IllyaMoore/Modular-10-10-inch-Rack---A1-mini-version/cad/minirack-assembly.FCStd

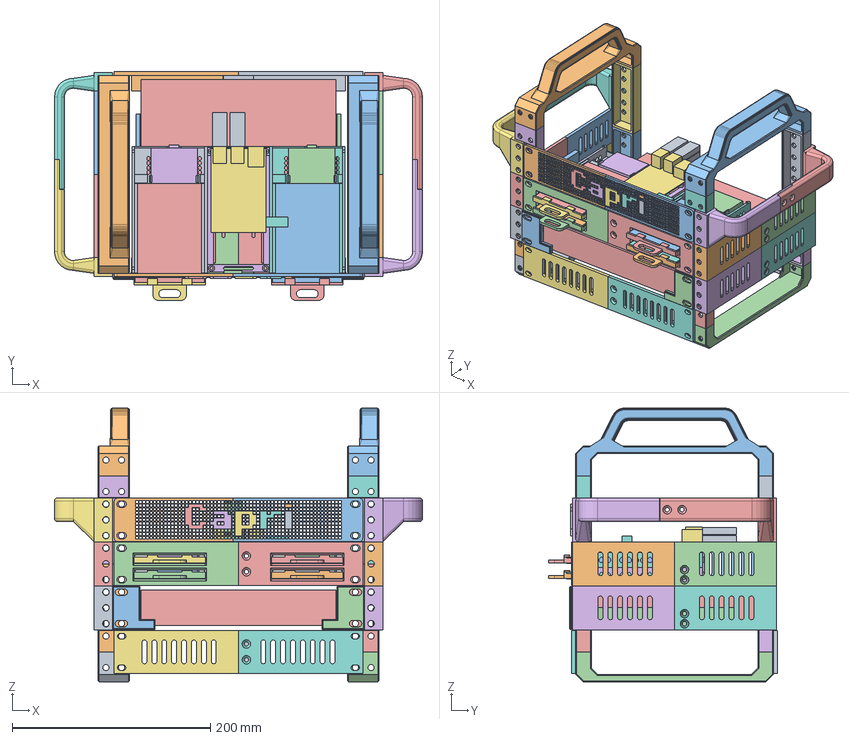
[picture p6: CAD file, 2026-11-12]
cad/minirack-assembly.FCStd
371.6 x 231.5 x 276.4 mm
foot_L
upright_front_L
upright_back_L
foot_R
upright_front_R
upright_back_R
join_front_L
join_front_R
join_back_L
join_back_R
mini_bracket_L
mini_bracket_R
macmini_ghost
upright_front_L_top
upright_back_L_top
upright_front_R_top
upright_back_R_top
handle_L
handle_R
nas_base_L
nas_base_R
nas_sock_R_low
nas_sock_L_low
nas_sock_R_up
nas_sock_L_up
hdd_1
sata_adapter_1
hdd_handle_1
hdd_2
sata_adapter_2
hdd_handle_2
hdd_3
sata_adapter_3
hdd_handle_3
hdd_4
sata_adapter_4
hdd_handle_4
sidesupport_U2_R_front
sidesupport_U2_L_front
sidesupport_U2_R_back
sidesupport_U2_L_back
sidesupport_U3_R_front
sidesupport_U3_L_front
sidesupport_U3_R_back
sidesupport_U3_L_back
nas_pi_holder
pi3b_board
pi3b_power_plug
pi3b_usb_plugs
cover_plate_L
cover_plate_R
cover_splice_bar
cover_letter_1
cover_letter_2
cover_letter_3
cover_letter_4
cover_letter_5
cover_letter_6
macmini_cover_L
macmini_cover_R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
