IllyaMoore/Modular-10-10-inch-Rack---A1-mini-version/print/cover/cover-plate.3mf

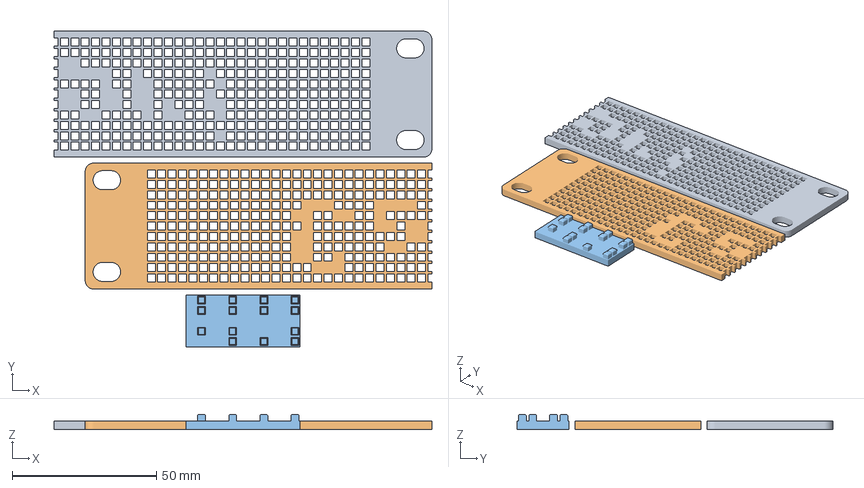
[picture p7: CAD file, 2026-11-12]
print/cover/cover-plate.3mf
130.9 x 109.3 x 5.20 mm
cover-plate-right.stl
cover-plate-left.stl
cover-splice-bar.stl
