IllyaMoore/Modular-10-10-inch-Rack---A1-mini-version/print/macmini/macmini-cover-left-right.3mf

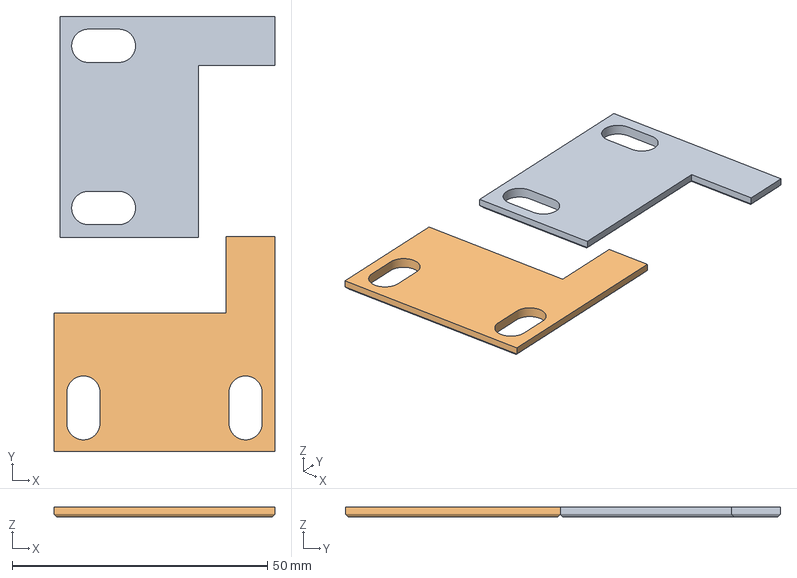
[picture p8: CAD file, 2026-11-12]
print/macmini/macmini-cover-left-right.3mf
43.3 x 85.2 x 2.00 mm
macmini-cover-left.stl
macmini-cover-right.stl
