IllyaMoore/Modular-10-10-inch-Rack---A1-mini-version/print/nas/nas-hdd-handle-x4.3mf

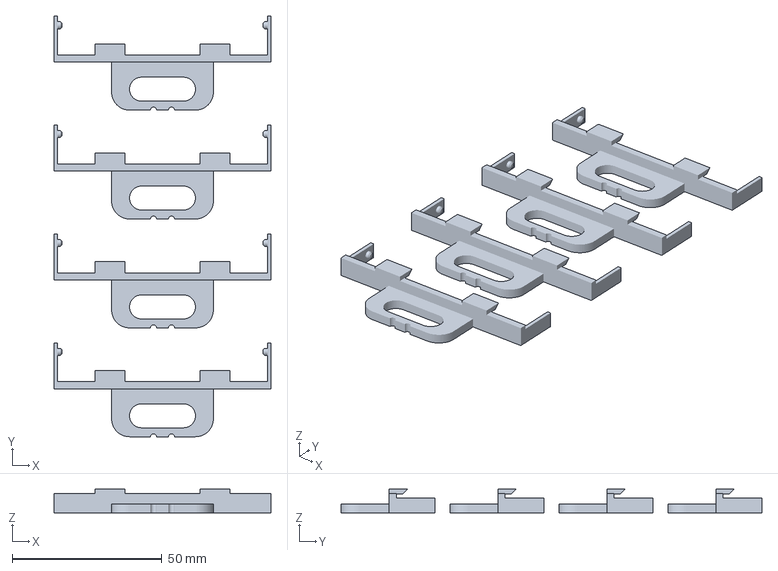
[picture p9: CAD file, 2026-11-12]
print/nas/nas-hdd-handle-x4.3mf
72.4 x 140.4 x 7.95 mm
