IllyaMoore/Modular-10-10-inch-Rack---A1-mini-version/print/shell/shell-foot-x2-gusset-x4.3mf

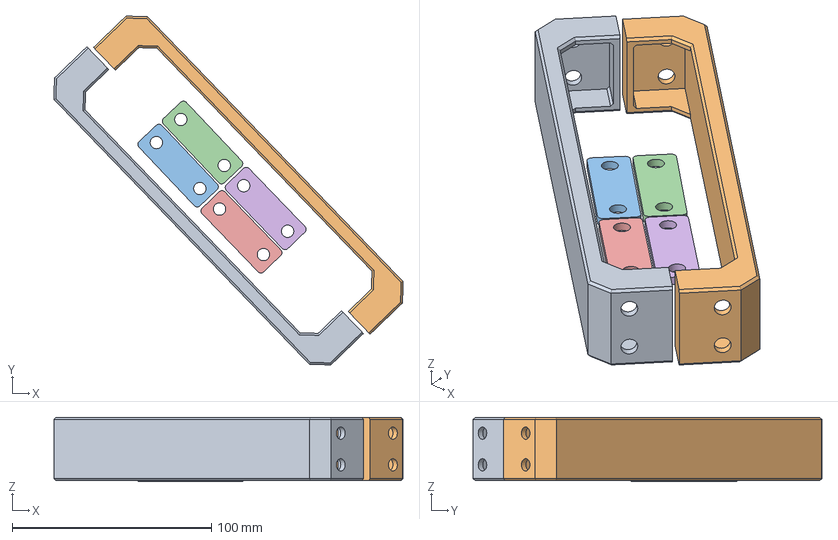
[picture p10: CAD file, 2026-11-12]
print/shell/shell-foot-x2-gusset-x4.3mf
175.2 x 175.0 x 32.3 mm
shell-foot-bwees.stl x 2
shell-gusset-1x3-bwees.stl x 4
