IllyaMoore/Modular-10-10-inch-Rack---A1-mini-version/stl/cover/cover-splice-bar.stl

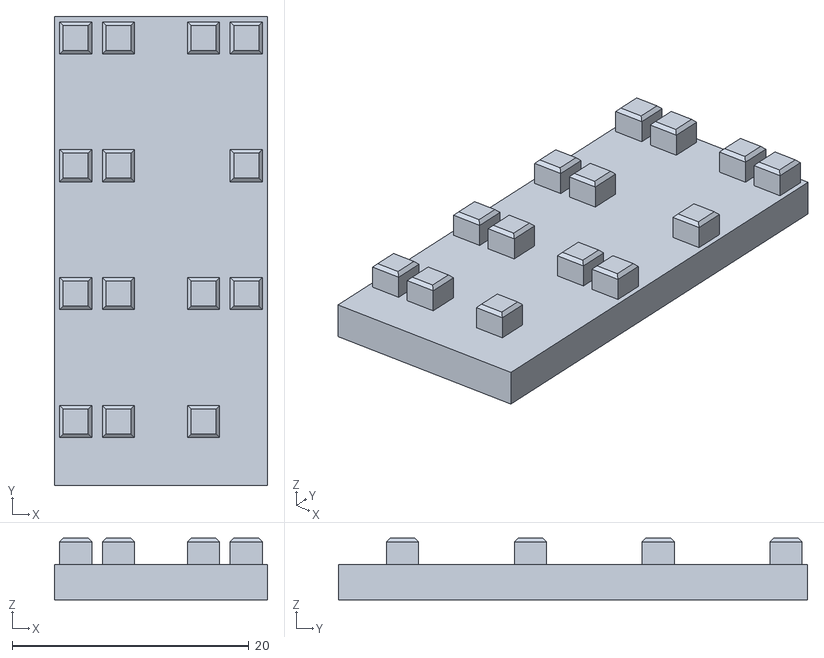
[picture p11: CAD file, 2026-11-12]
stl/cover/cover-splice-bar.stl
18.0 x 39.6 x 5.20
