IllyaMoore/Modular-10-10-inch-Rack---A1-mini-version/stl/macmini/macmini-cover-left.stl

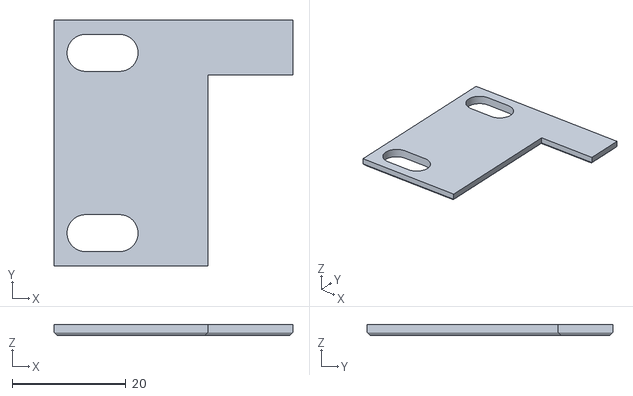
[picture p12: CAD file, 2026-11-12]
stl/macmini/macmini-cover-left.stl
42.1 x 43.3 x 2.00
