IllyaMoore/Modular-10-10-inch-Rack---A1-mini-version/stl/nas/nas-socket-bracket.stl

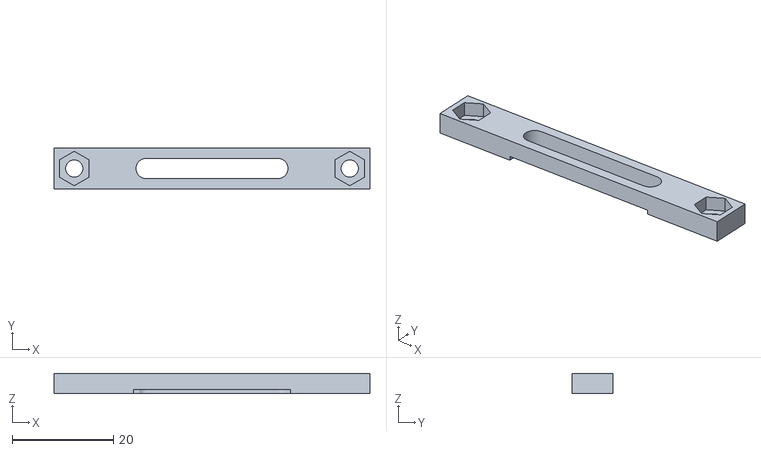
[picture p13: CAD file, 2026-11-12]
stl/nas/nas-socket-bracket.stl
62.4 x 8.00 x 4.00
