IllyaMoore/Modular-10-10-inch-Rack---A1-mini-version/stl/shell/shell-side-handle-front.stl

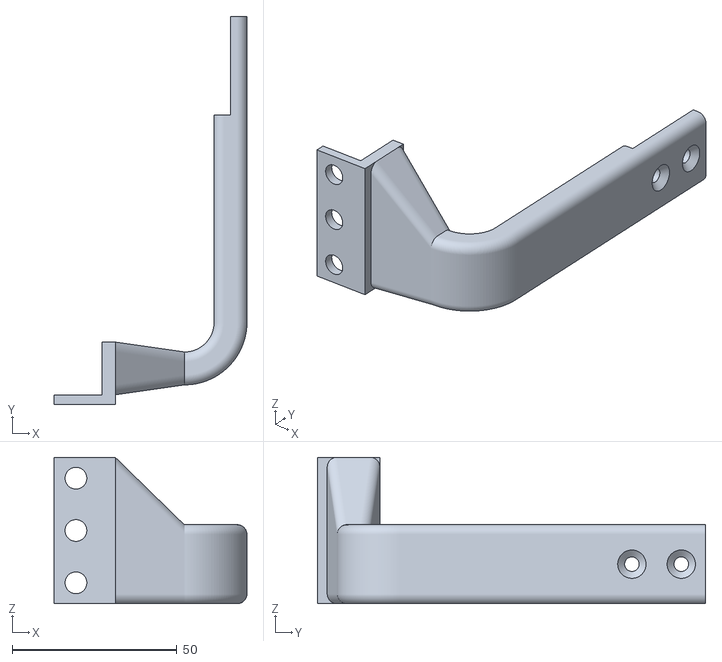
[picture p14: CAD file, 2026-11-12]
stl/shell/shell-side-handle-front.stl
58.6 x 117.9 x 44.5
