IllyaMoore/Modular-10-10-inch-Rack---A1-mini-version/cad/nas-layer.FCStd

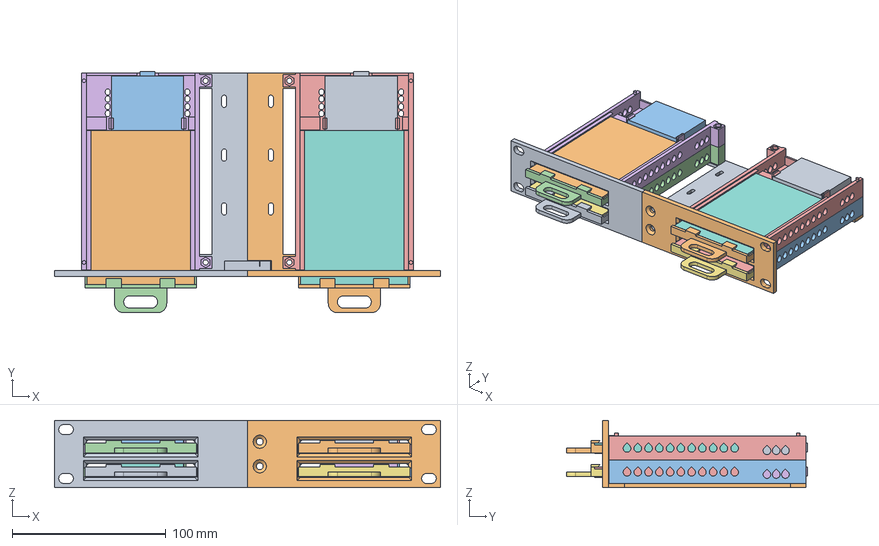
[picture p15: CAD file, 2026-11-12]
cad/nas-layer.FCStd
251.0 x 157.0 x 43.7 mm
base_L
base_R
sock_R_low
sock_L_low
sock_R_up
sock_L_up
drive_1
adapter_1
handle_1
drive_2
adapter_2
handle_2
drive_3
adapter_3
handle_3
drive_4
adapter_4
handle_4
