IllyaMoore/Modular-10-10-inch-Rack---A1-mini-version/print/cover/cover-letters.3mf

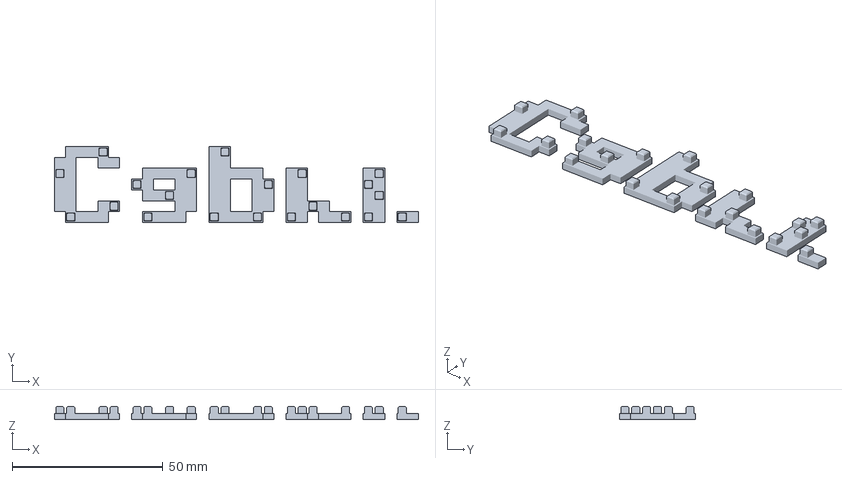
[picture p16: CAD file, 2026-11-12]
print/cover/cover-letters.3mf
120.8 x 25.2 x 4.20 mm
