IllyaMoore/Modular-10-10-inch-Rack---A1-mini-version/print/macmini/macmini-holder-left-right.3mf

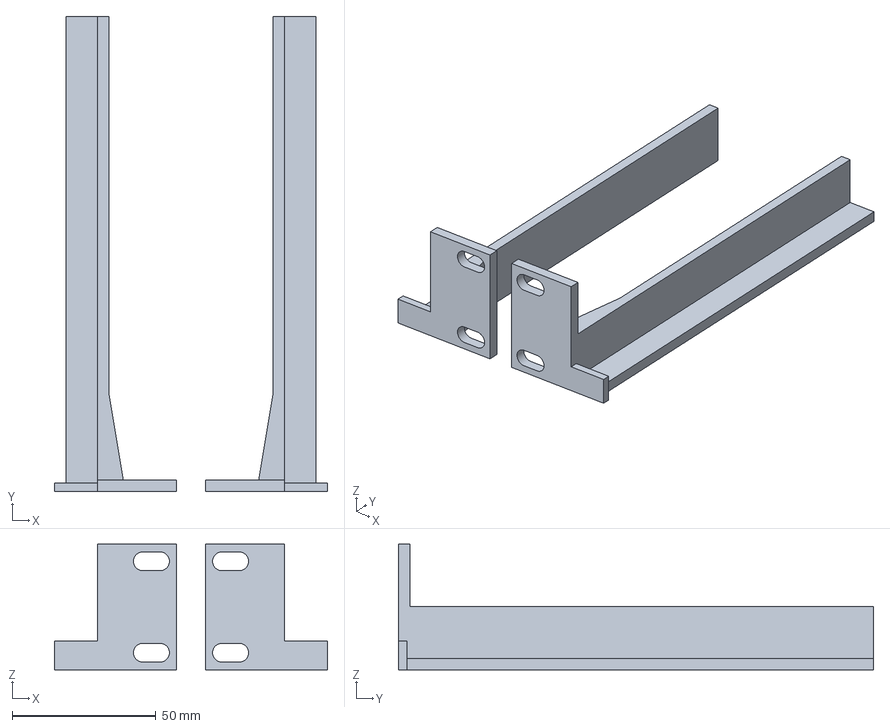
[picture p17: CAD file, 2026-11-12]
print/macmini/macmini-holder-left-right.3mf
95.0 x 165.0 x 43.7 mm
