IllyaMoore/Modular-10-10-inch-Rack---A1-mini-version/print/shell/shell-top-handle.3mf

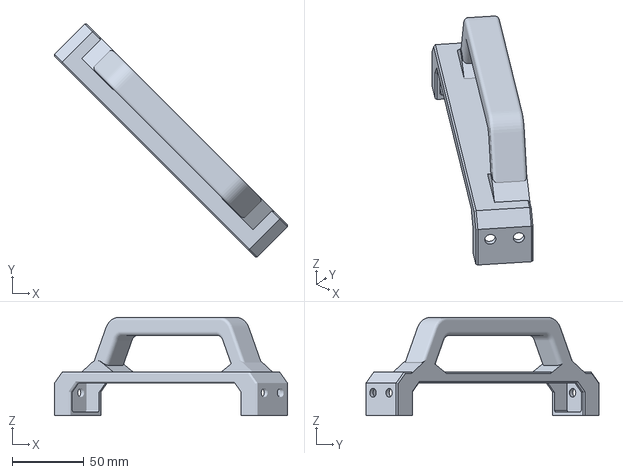
[picture p18: CAD file, 2026-11-12]
print/shell/shell-top-handle.3mf
162.5 x 162.5 x 68.4 mm
