IllyaMoore/Modular-10-10-inch-Rack---A1-mini-version/stl/cover/cover-plate-right.stl

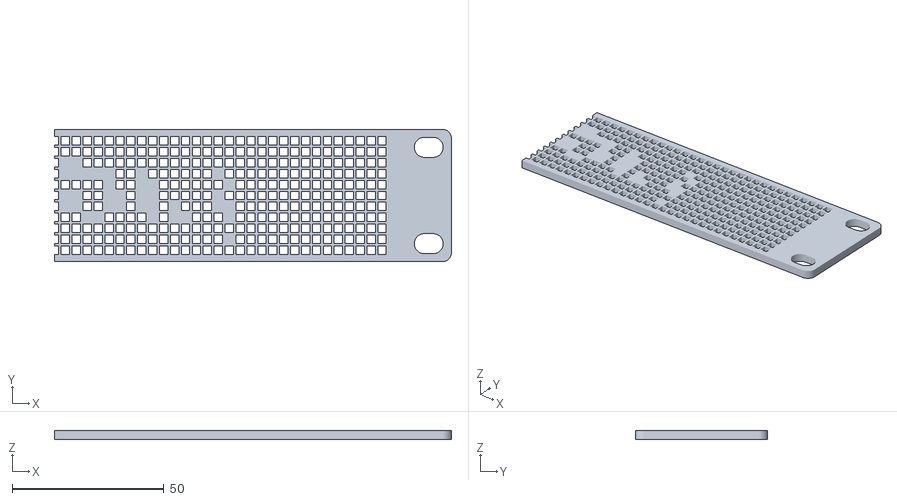
[picture p19: CAD file, 2026-11-12]
stl/cover/cover-plate-right.stl
130.9 x 43.7 x 3.00
