IllyaMoore/Modular-10-10-inch-Rack---A1-mini-version/STL/nas/nas-socket-left.stl

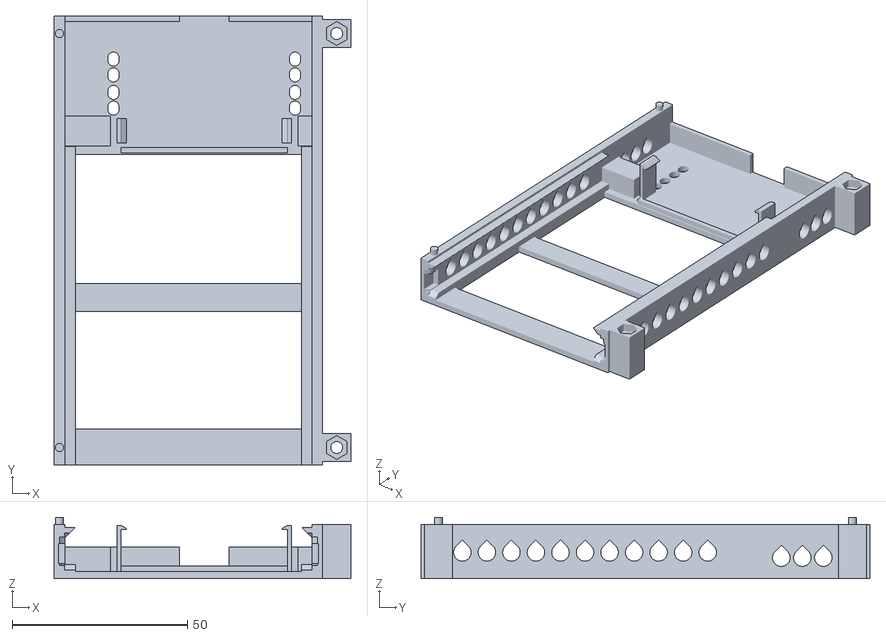
[picture p20: CAD file, 2026-11-09]
STL/nas/nas-socket-left.stl
84.6 x 128.1 x 17.5
