IllyaMoore/Modular-10-10-inch-Rack---A1-mini-version/print/nas/nas-pi-holder-pins.3mf

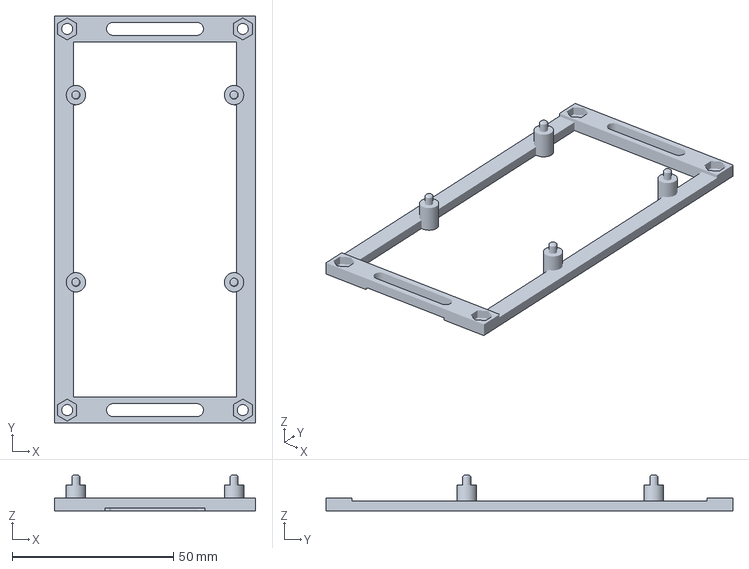
[picture p21: CAD file, 2026-11-12]
print/nas/nas-pi-holder-pins.3mf
62.4 x 126.1 x 11.0 mm
