IllyaMoore/Modular-10-10-inch-Rack---A1-mini-version/print/shell/shell-upright-3u-x4.3mf

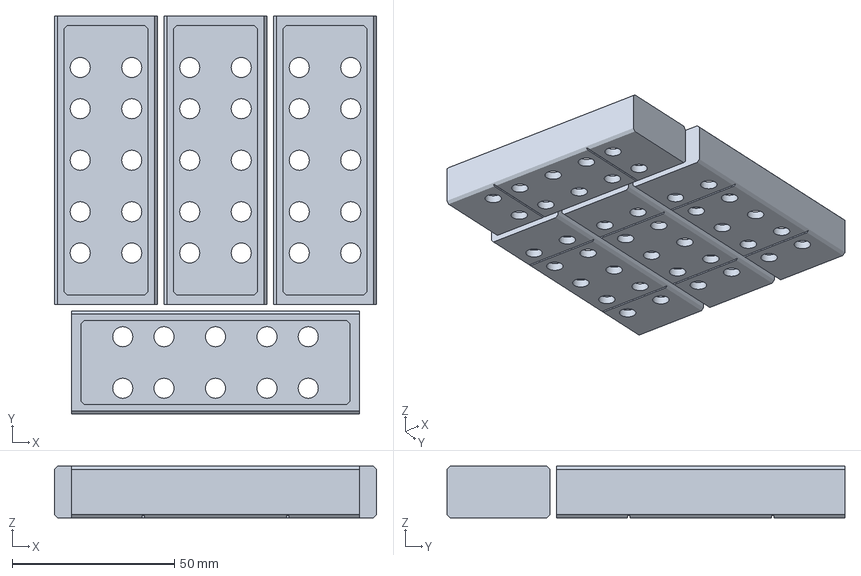
[picture p22: CAD file, 2026-11-12]
print/shell/shell-upright-3u-x4.3mf
99.2 x 122.7 x 15.9 mm
