IllyaMoore/Modular-10-10-inch-Rack---A1-mini-version/stl/cover/cover-plate-left.stl

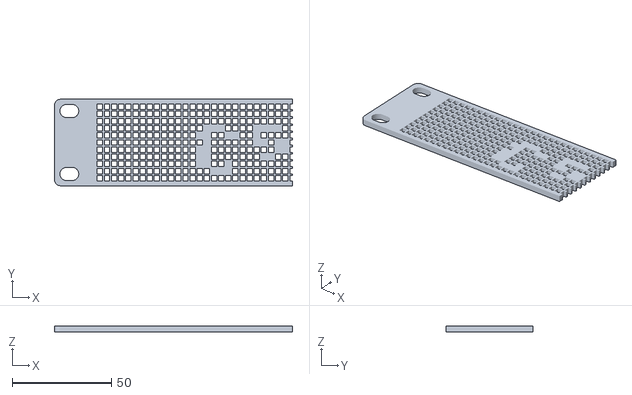
[picture p23: CAD file, 2026-11-12]
stl/cover/cover-plate-left.stl
120.1 x 43.7 x 3.00
