IllyaMoore/Modular-10-10-inch-Rack---A1-mini-version/stl/macmini/macmini-holder-right.stl

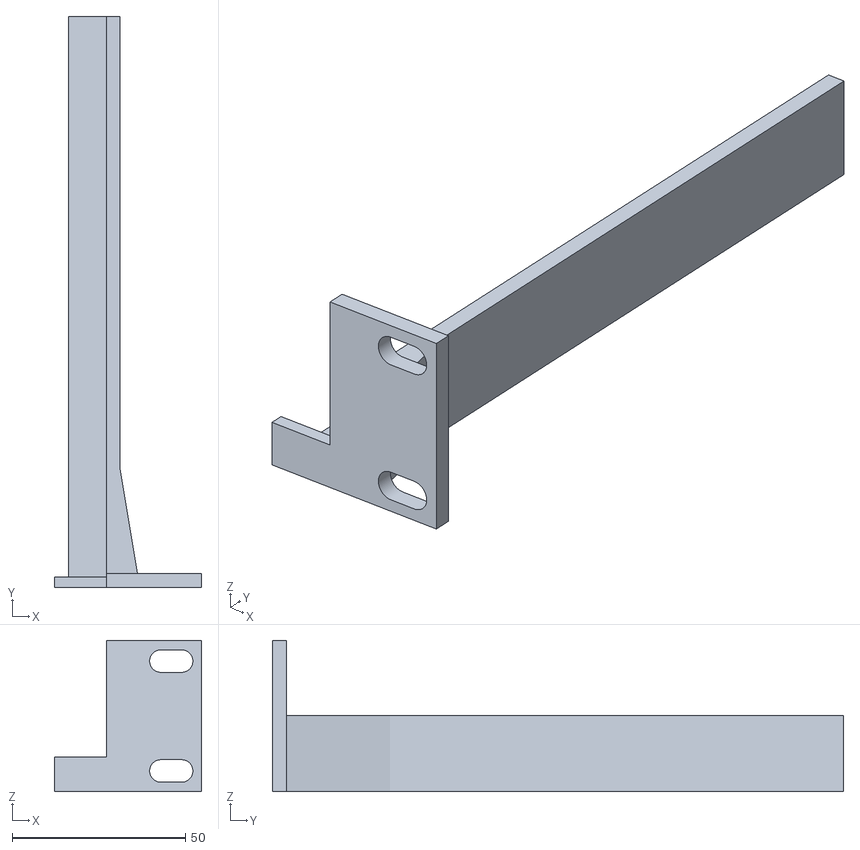
[picture p24: CAD file, 2026-11-04]
stl/macmini/macmini-holder-right.stl
42.5 x 165.0 x 43.7
