IllyaMoore/Modular-10-10-inch-Rack---A1-mini-version/stl/shell/shell-side-support-back.stl

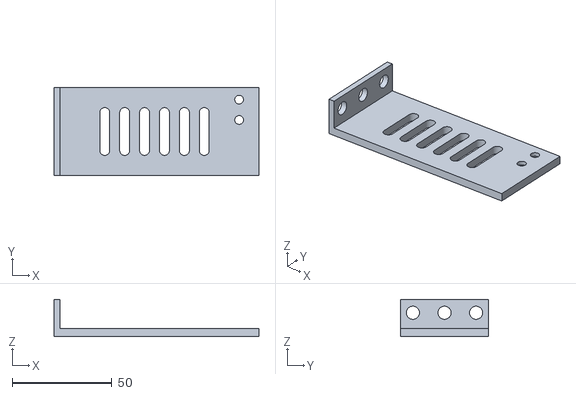
[picture p25: CAD file, 2026-11-09]
stl/shell/shell-side-support-back.stl
103.0 x 44.5 x 18.6
