IllyaMoore/Modular-10-10-inch-Rack---A1-mini-version/print/nas/nas-socket-bracket-x2.3mf

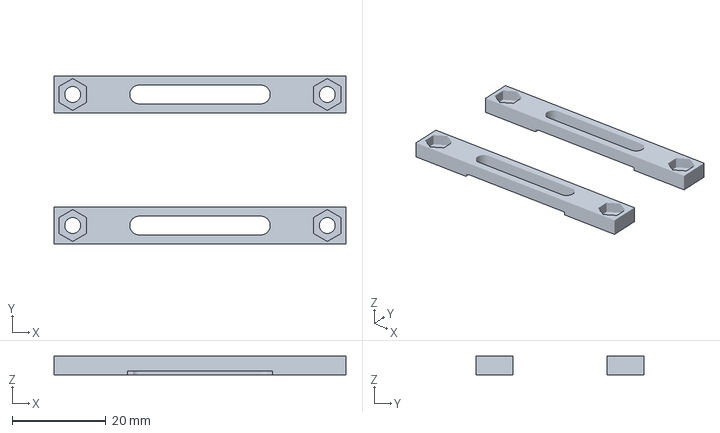
[picture p26: CAD file, 2026-11-12]
print/nas/nas-socket-bracket-x2.3mf
62.4 x 36.0 x 4.00 mm
