IllyaMoore/Modular-10-10-inch-Rack---A1-mini-version/print/shell/shell-side-handle-front-back.3mf

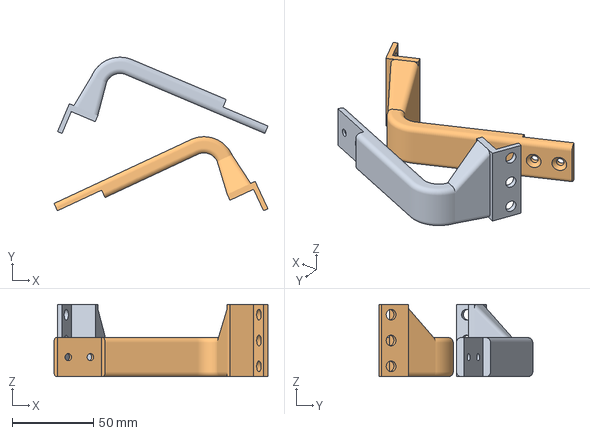
[picture p27: CAD file, 2026-11-12]
print/shell/shell-side-handle-front-back.3mf
131.6 x 94.5 x 44.5 mm
shell-side-handle-back.stl
shell-side-handle-front.stl
