IllyaMoore/Modular-10-10-inch-Rack---A1-mini-version/stl/nas/nas-hdd-handle-landing-2.0mm.stl

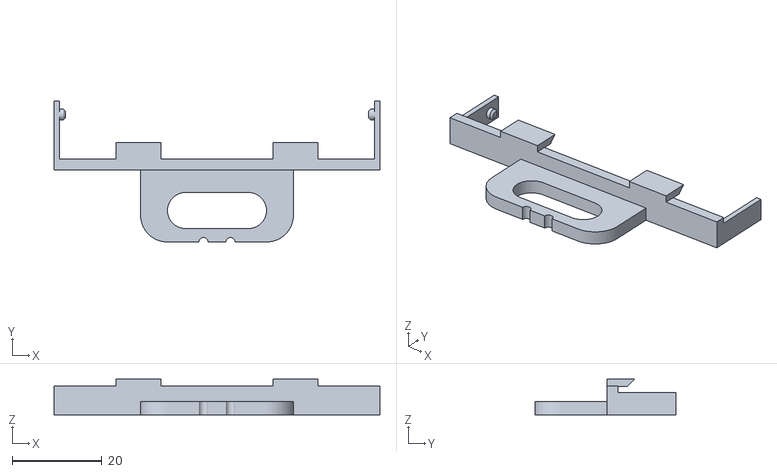
[picture p28: CAD file, 2026-11-09]
stl/nas/nas-hdd-handle-landing-2.0mm.stl
72.4 x 31.4 x 7.95
