IllyaMoore/Modular-10-10-inch-Rack---A1-mini-version/stl/shell/shell-side-support-front.stl

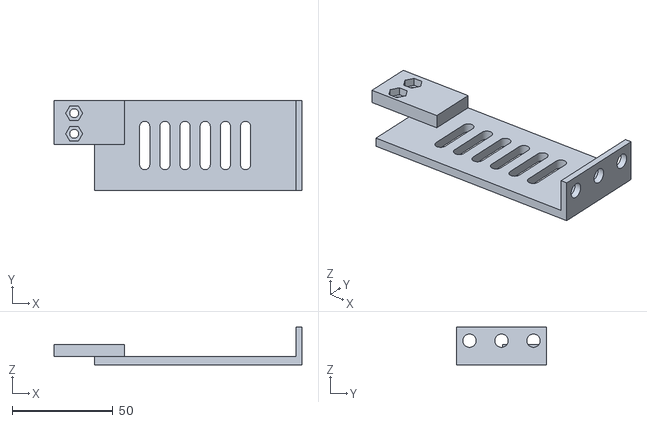
[picture p29: CAD file, 2026-11-09]
stl/shell/shell-side-support-front.stl
123.0 x 44.5 x 18.6
