IllyaMoore/Modular-10-10-inch-Rack---A1-mini-version/print/nas/nas-socket-left-right.3mf

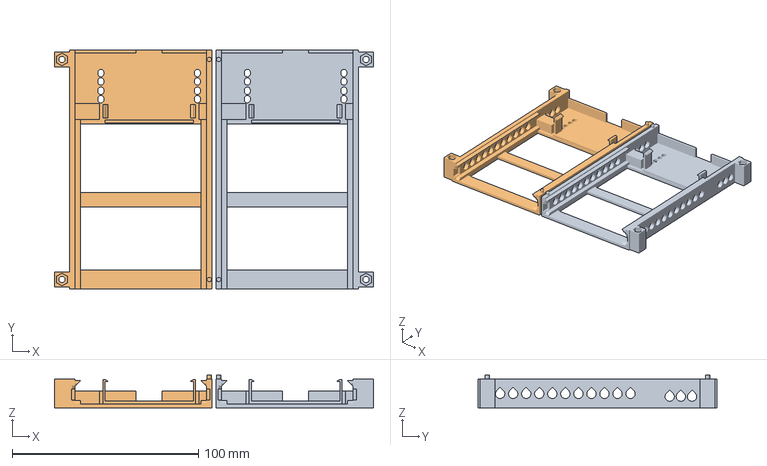
[picture p30: CAD file, 2026-11-09]
print/nas/nas-socket-left-right.3mf
171.2 x 128.1 x 17.5 mm
nas-socket-left.stl
nas-socket-right.stl
