IllyaMoore/Modular-10-10-inch-Rack---A1-mini-version/print/shell/shell-side-support-front-back.3mf

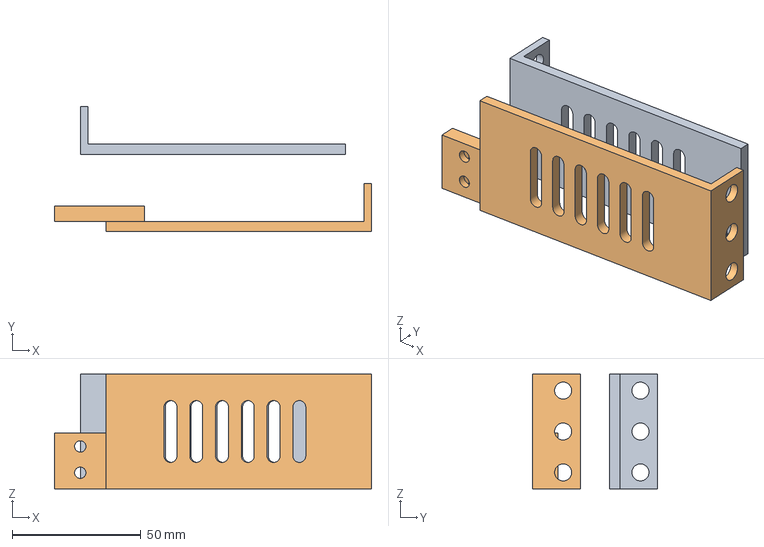
[picture p31: CAD file, 2026-11-12]
print/shell/shell-side-support-front-back.3mf
123.0 x 48.6 x 44.5 mm
shell-side-support-back.stl
shell-side-support-front.stl
