IllyaMoore/Modular-10-10-inch-Rack---A1-mini-version/stl/shell/shell-join-plate-left.stl

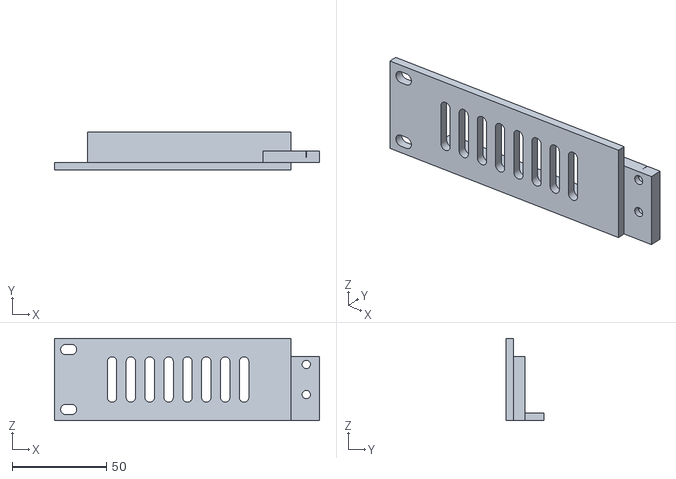
[picture p33: CAD file, 2026-11-04]
stl/shell/shell-join-plate-left.stl
140.5 x 20.0 x 43.7
