IllyaMoore/Modular-10-10-inch-Rack---A1-mini-version/print/shell/shell-join-plate-left-right.3mf

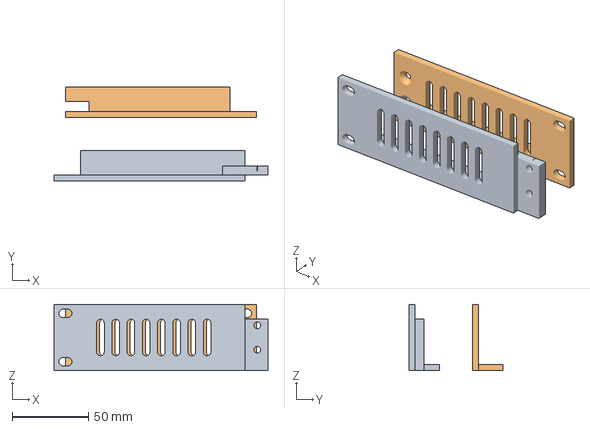
[picture p35: CAD file, 2026-11-12]
print/shell/shell-join-plate-left-right.3mf
140.5 x 61.8 x 43.7 mm
shell-join-plate-left.stl
shell-join-plate-right.stl
