IllyaMoore/Modular-10-10-inch-Rack---A1-mini-version/stl/shell/shell-top-handle-bwees.stl

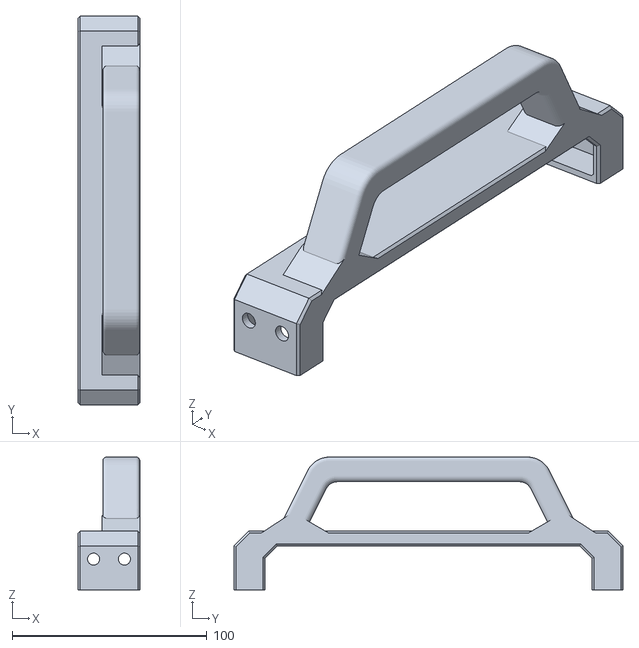
[picture p36: CAD file, 2026-11-04]
stl/shell/shell-top-handle-bwees.stl
31.8 x 200.0 x 68.4
