IllyaMoore/Modular-10-10-inch-Rack---A1-mini-version/print/nas/nas-adapter-holder-test.3mf

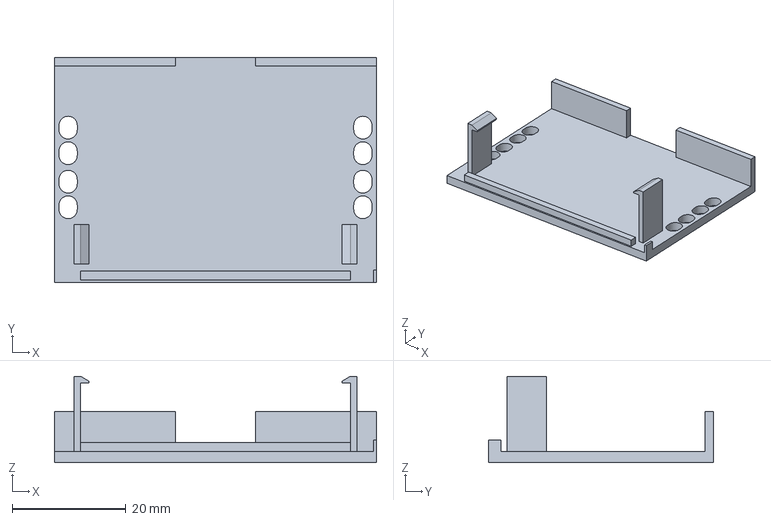
[picture p37: CAD file, 2026-11-09]
print/nas/nas-adapter-holder-test.3mf
56.6 x 39.5 x 15.2 mm
