IllyaMoore/Modular-10-10-inch-Rack---A1-mini-version/stl/shell/shell-join-plate-right.stl

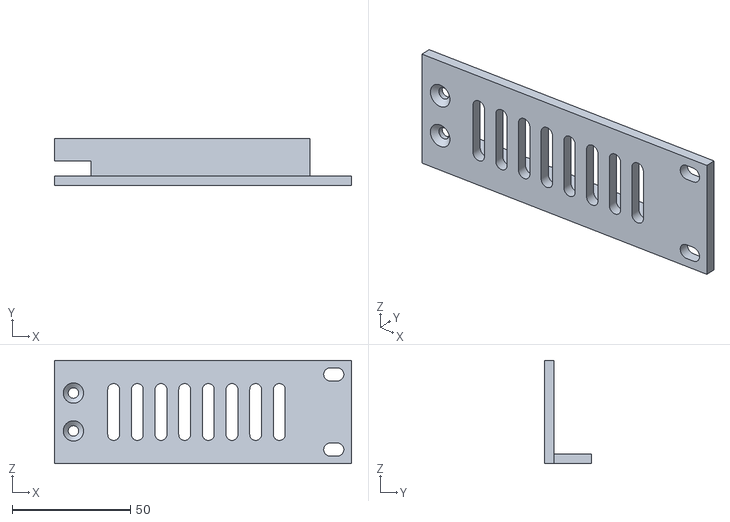
[picture p38: CAD file, 2026-11-04]
stl/shell/shell-join-plate-right.stl
125.5 x 20.0 x 43.7
