IllyaMoore/Modular-10-10-inch-Rack---A1-mini-version/print/nas/nas-base-left.3mf

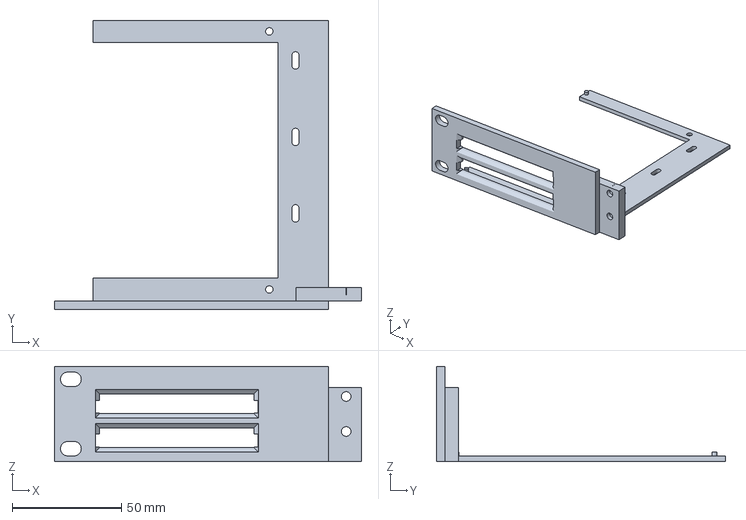
[picture p39: CAD file, 2026-11-09]
print/nas/nas-base-left.3mf
140.5 x 132.3 x 43.7 mm
