IllyaMoore/Modular-10-10-inch-Rack---A1-mini-version/stl/shell/shell-gusset-1x3-bwees.stl

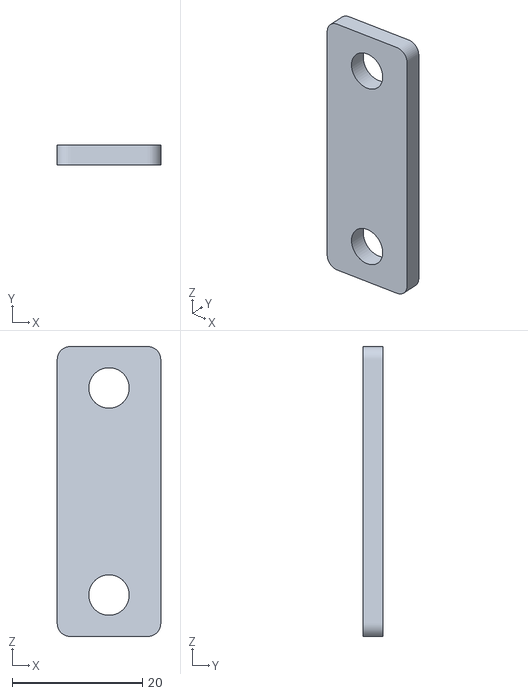
[picture p40: CAD file, 2026-11-04]
stl/shell/shell-gusset-1x3-bwees.stl
15.9 x 3.00 x 44.5
