IllyaMoore/Modular-10-10-inch-Rack---A1-mini-version/stl/shell/shell-foot-bwees.stl

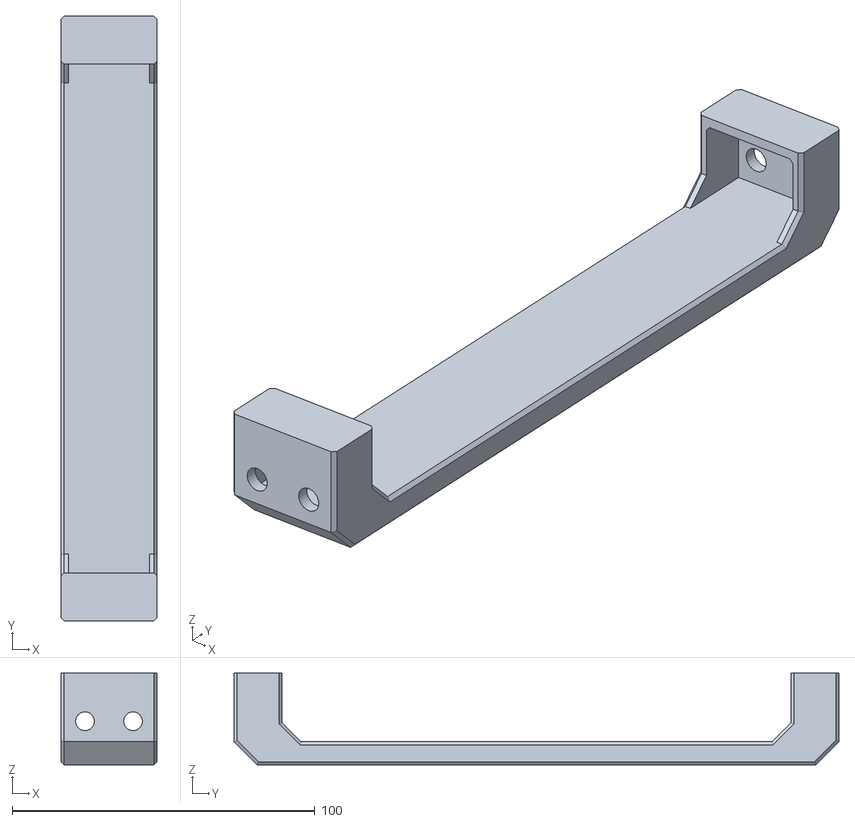
[picture p41: CAD file, 2026-11-04]
stl/shell/shell-foot-bwees.stl
31.8 x 200.0 x 30.3
