IllyaMoore/Modular-10-10-inch-Rack---A1-mini-version/stl/shell/shell-upright-3u-bwees.stl

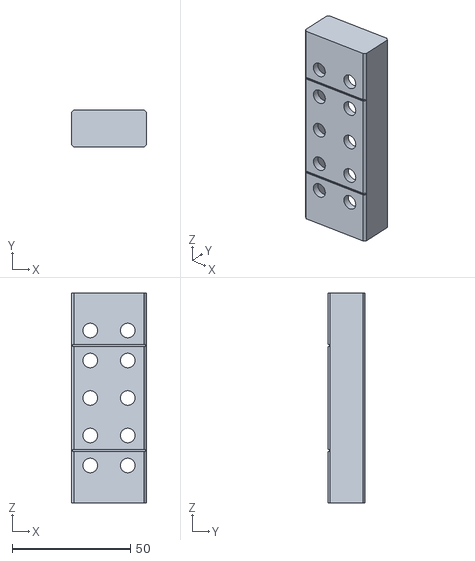
[picture p42: CAD file, 2026-11-04]
stl/shell/shell-upright-3u-bwees.stl
31.8 x 15.9 x 88.9
