IllyaMoore/Modular-10-10-inch-Rack---A1-mini-version/(list of files, cad)

Other CAD files:
stl/macmini/macmini-cover-right.stl
stl/shell/shell-side-handle-back.stl
STL/nas/nas-socket-right.stl
stl/macmini/macmini-holder-left.stl
stl/nas/nas-hdd-handle-landing-1.5mm.stl
STL/nas/nas-adapter-holder-test.stl
STL/nas/nas-base-left.stl
STL/nas/nas-base-right.stl
print/nas/nas-pi-holder-screws.3mf
stl/cover/cover-letters.stl
stl/nas/nas-adapter-holder-test.stl
stl/nas/nas-base-left.stl
stl/nas/nas-base-right.stl
stl/nas/nas-pi-holder-pins.stl
stl/nas/nas-pi-holder-screws.stl
stl/nas/nas-socket-right.stl
