IllyaMoore/Modular-10-10-inch-Rack---A1-mini-version/(commit log)

2026-11-04 stl & ready to print files
    [Modular Rack 1x3 Gusset.stl, Modular Rack 3U Upright.stl, Modular Rack Bottom Foot.stl, Modular Rack Side Support.stl, Modular Rack Top Handle Minimal Overhangs.stl, feet-x2-gussets-x4.3mf, macmini2012-holder-left.stl, macmini2012-holder-plate.3mf]
2026-11-05 side support model
    [minirack-assembly.FCStd, side-support-back-half.stl, side-support-front-half.stl, side-support-x1.stl]
2026-11-09 mol updates
    [minirack-assembly.FCStd, nas-adapter-holder-test.stl, nas-base-left.stl, nas-base-right.stl, nas-modular.FCStd, nas-socket-fit-test.stl, nas-socket-left.stl, nas-socket-right.stl]
2026-11-09 Restructure repo: per-layer folders, 3mf print plates, NAS-only rack
    - STL/ (was stl/): shell (was rack), macmini, nas
    - ReadyToPrint/: one Bambu Studio .3mf project per plate, sorted into
    shell / macmini / nas (A1 mini, 0.20 Standard, PETG; feet plate keeps
    its supports, everything else prints without)
    - NAS: snap-wall adapter holder, zip-tie slots restored, adapter holder
    test plate; old socket fit test removed
    - Control floor removed for now (model, STL, plates, README, render)
    - README simplified; renders re-made with a fixed camera (no clipping)
    [bwees-bottom-foot.stl, bwees-gusset-1x3.stl, bwees-side-support-full.stl, bwees-top-handle.stl, bwees-upright-3u.stl, control-floor-pi-hub-left.stl, control-floor-pi-hub-right.stl, hdd-handle-landing-1.5-2.0-2.5mm-x3.stl]
2026-11-10 NAS: add USB hub mount behind the drive slots
    - New STL/nas/nas-hub-mount.stl + ReadyToPrint/nas/nas-hub-mount.3mf
    (43 min, no supports): hub 76 x 41 x 21 lies flat right behind the
    sockets, ports facing back; held by a tongue under the NAS base using
    the 2 rear socket bolts (M3 x 40 there), 2 zip ties; open short ends
    for the hub's input cable and DC jack; skeleton base (-29% PETG)
    - Drive cable routes 112-118 mm of the 13 cm adapter cables
    - README NAS section, renders and FreeCAD models updated
    [minirack-assembly.FCStd, nas-hub-mount.3mf, nas-hub-mount.stl, nas-level-modular.FCStd]
2026-11-12 Revision v1.0 final base build
    [bwees-side-support-full.stl, cover-letters.3mf, cover-letters.stl, cover-plate-left.stl, cover-plate-right.stl, cover-plate.3mf, cover-splice-bar.stl, macmini-cover-left-right.3mf]
